Ryzzen/RyzzenKeyboard/layout/output.stl

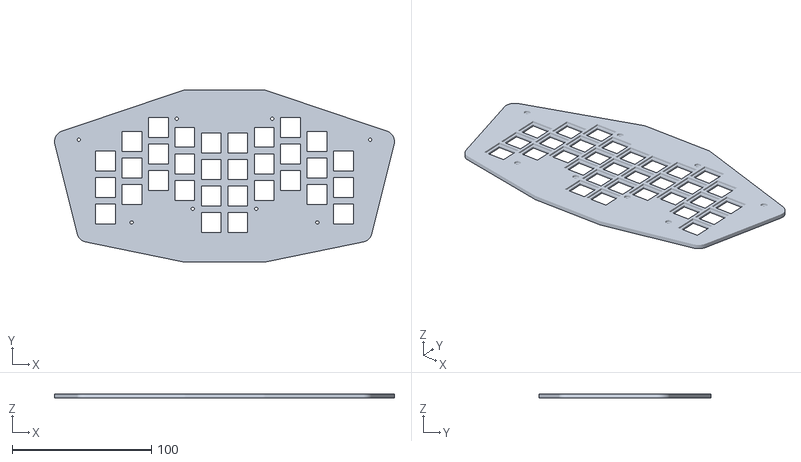
[picture p20: CAD file, 2026-03-23]
layout/output.stl
244.1 x 123.8 x 3.00
