Ryzzen/RyzzenKeyboard/layout/output/outlines/m2_countersink.dxf

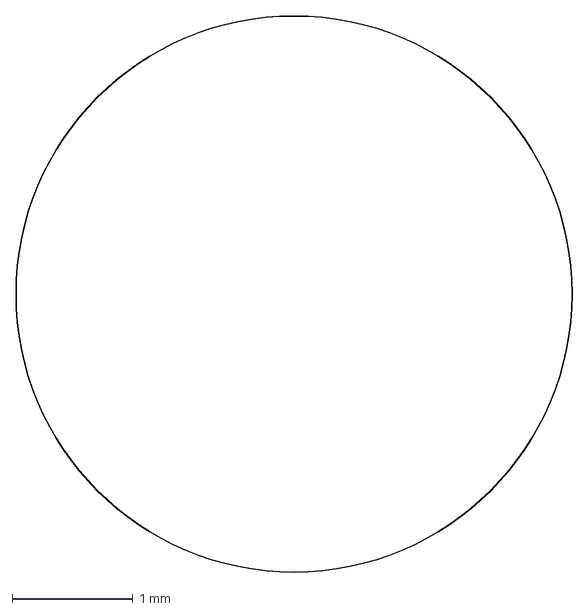
[picture p21: CAD file, 2026-03-23]
layout/output/outlines/m2_countersink.dxf
4.60 x 4.60 mm
