Ryzzen/RyzzenKeyboard/librairies/ECS-250-8-30B-CKM/ECS-250-8-30B-CKM.step

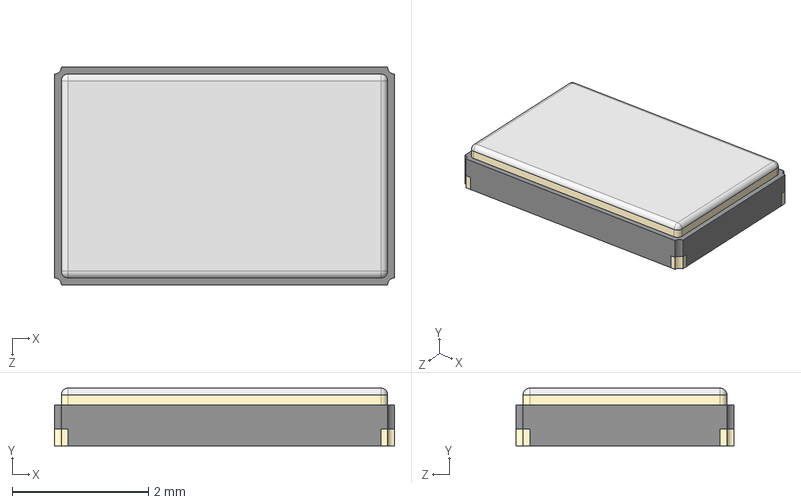
[picture p22: CAD file, 2025-12-25]
librairies/ECS-250-8-30B-CKM/ECS-250-8-30B-CKM.step
5.00 x 0.85 x 3.20 mm
