Ryzzen/RyzzenKeyboard/layout/output/outlines/m2_through.dxf

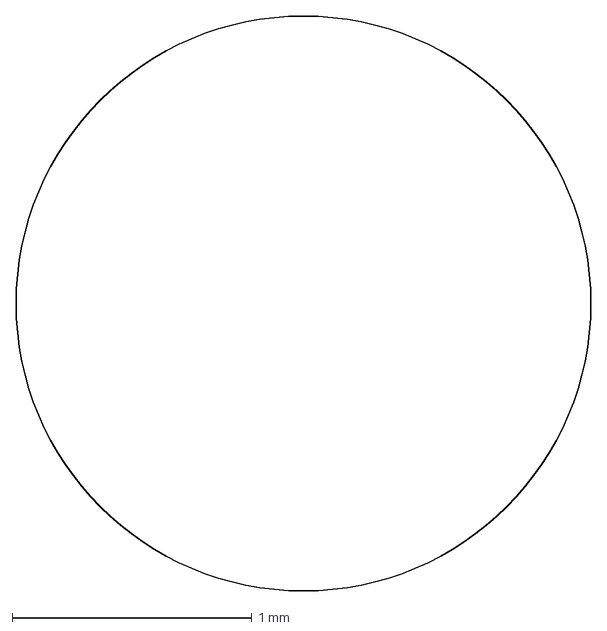
[picture p23: CAD file, 2026-03-23]
layout/output/outlines/m2_through.dxf
2.40 x 2.40 mm
