Ryzzen/RyzzenKeyboard/layout/output/outlines/switch_cutout_retention.dxf

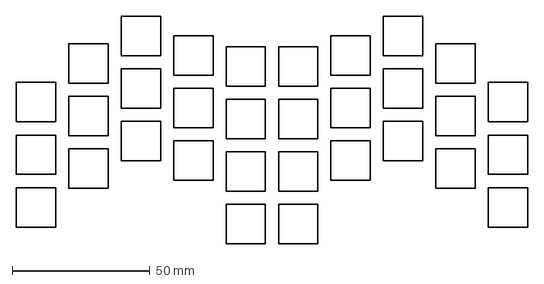
[picture p24: CAD file, 2026-03-23]
layout/output/outlines/switch_cutout_retention.dxf
185.3 x 82.4 mm
