Ryzzen/RyzzenKeyboard/layout/output/outlines/board.dxf

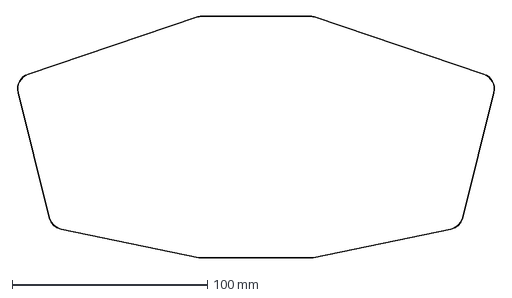
[picture p25: CAD file, 2026-03-23]
layout/output/outlines/board.dxf
245.7 x 123.8 mm
