Ryzzen/RyzzenKeyboard/layout/output/outlines/plate_top.dxf

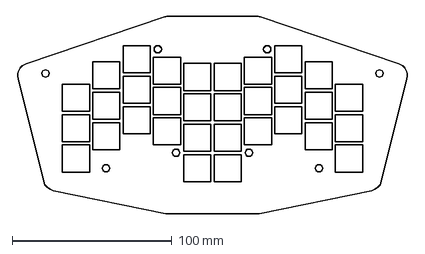
[picture p26: CAD file, 2026-03-23]
layout/output/outlines/plate_top.dxf
245.7 x 123.8 mm
