Ryzzen/RyzzenKeyboard/layout/output/outlines/plate_bottom.dxf

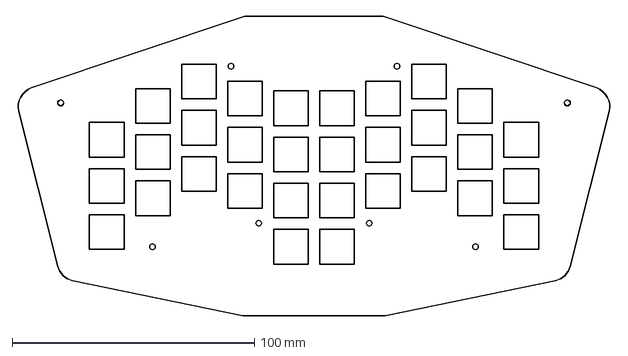
[picture p27: CAD file, 2026-03-23]
layout/output/outlines/plate_bottom.dxf
245.7 x 123.8 mm
