Ryzzen/RyzzenKeyboard/layout/output/outlines/plate_holes.dxf

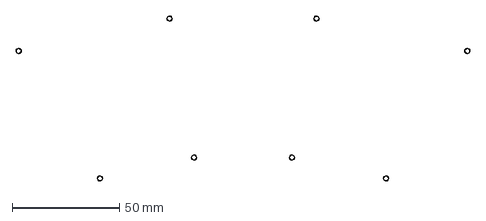
[picture p28: CAD file, 2026-03-23]
layout/output/outlines/plate_holes.dxf
211.6 x 76.9 mm
