Ryzzen/RyzzenKeyboard/layout/output/outlines/plate_countersinks.dxf

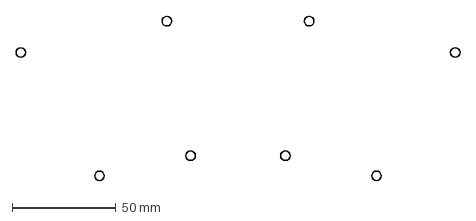
[picture p29: CAD file, 2026-03-23]
layout/output/outlines/plate_countersinks.dxf
213.8 x 79.1 mm
