Ryzzen/RyzzenKeyboard/layout/output/outlines/switch_cutout_clearance.dxf

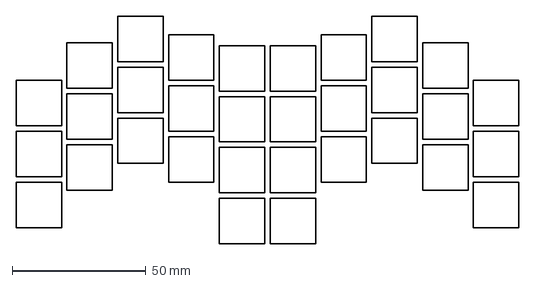
[picture p30: CAD file, 2026-03-23]
layout/output/outlines/switch_cutout_clearance.dxf
188.1 x 85.2 mm
