Ryzzen/RyzzenKeyboard/(list of files, cad)

Other CAD files:
layout/plate.FCStd
