Ryzzen/RyzzenKeyboard/RyzzenKeyboard.kicad_pcb

## KiCad design RyzzenKeyboard.kicad_pcb (2026-04-11)

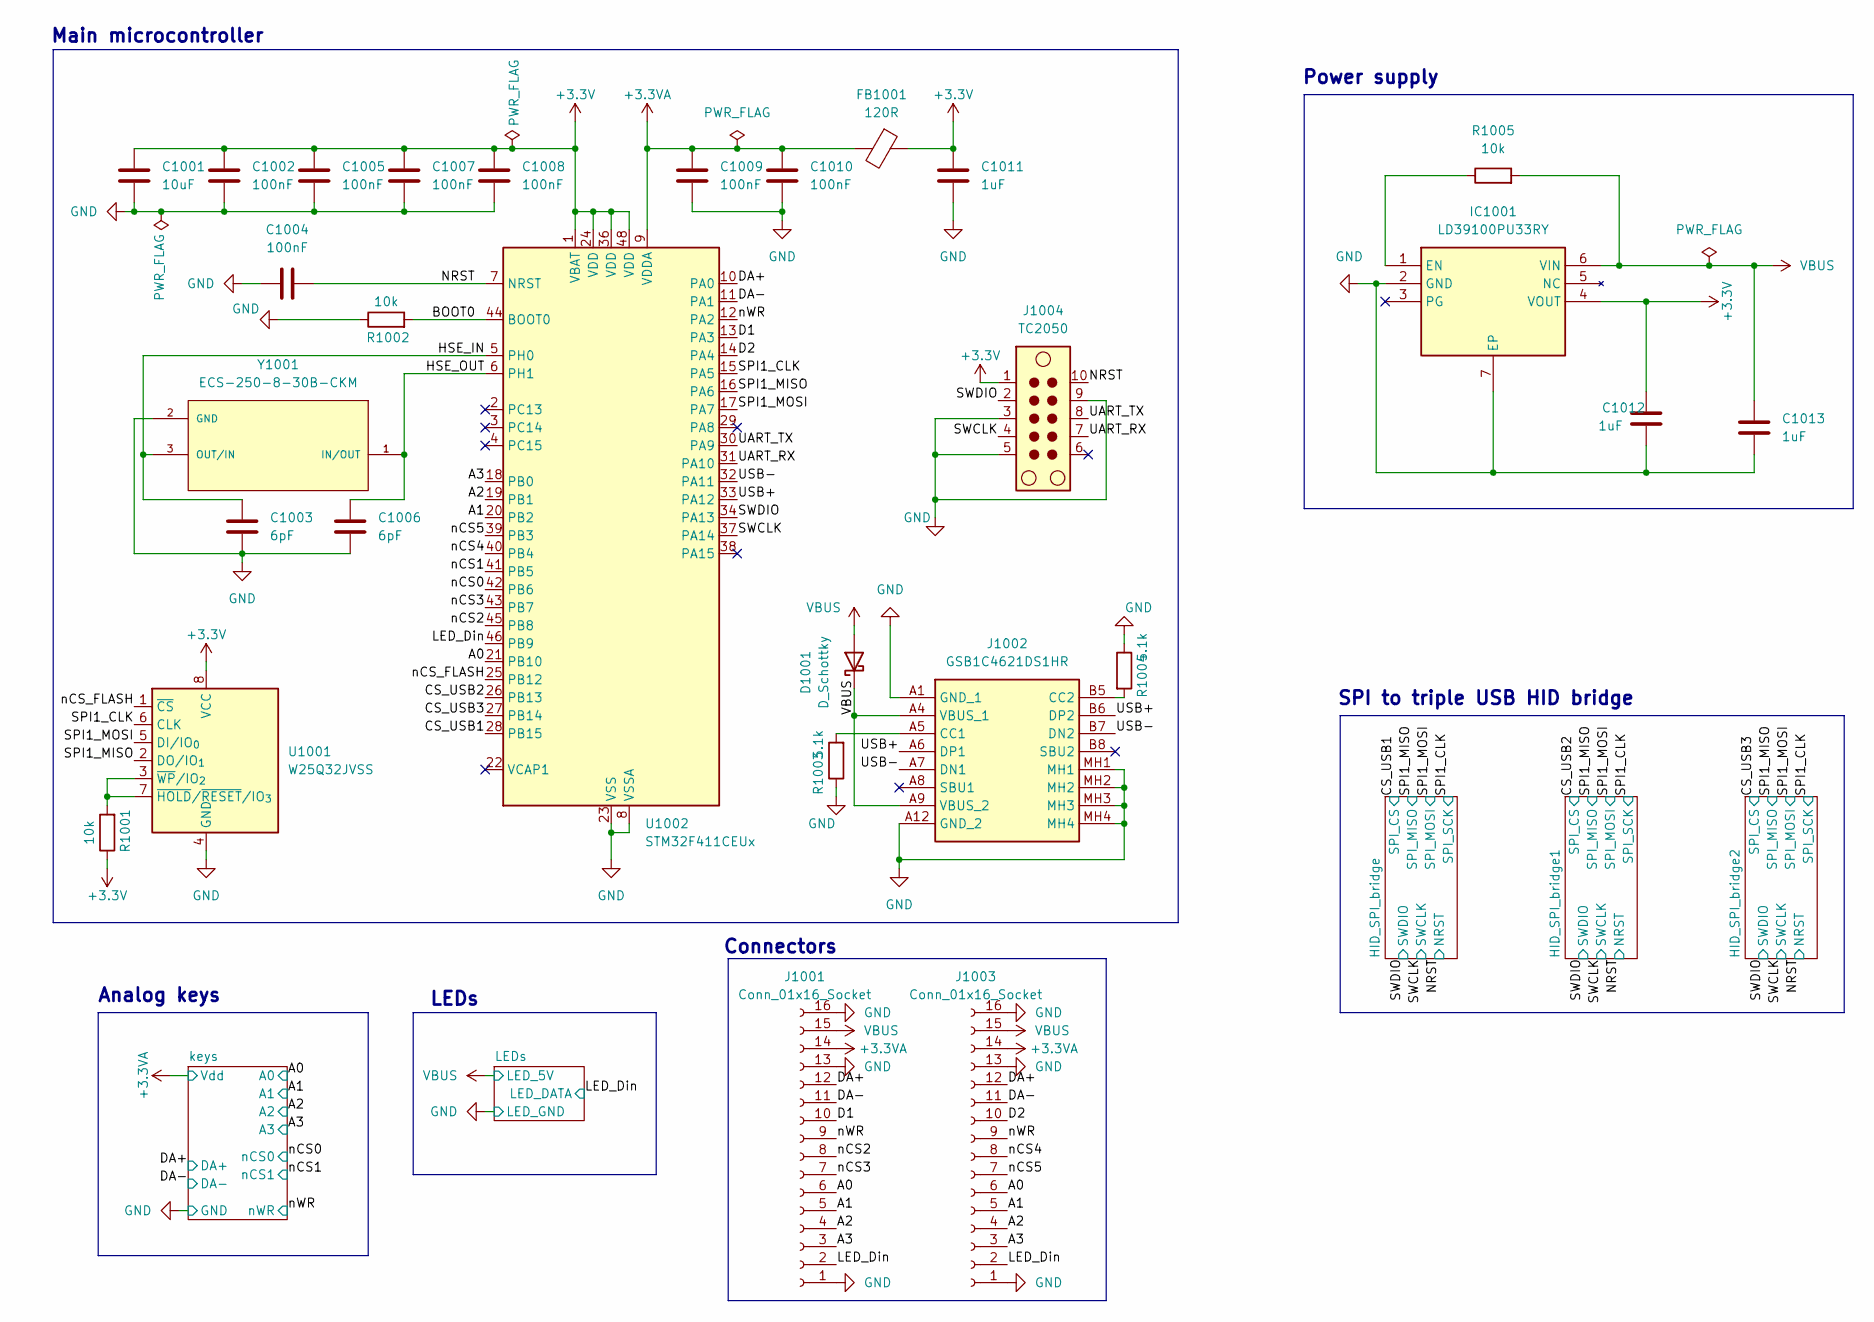
[picture p31: schematic RyzzenKeyboard.kicad_sch, TMR based triple USB Keyboard]

Parts:
C1001: 10uF; C_0603_1608Metric_Pad1.08x0.95mm_HandSolder
C1002, C1004, C1005, C1007, C1008, C1009, C1010: 100nF; C_0603_1608Metric_Pad1.08x0.95mm_HandSolder
C1003, C1006: 6pF; C_0603_1608Metric_Pad1.08x0.95mm_HandSolder
C1011, C1012, C1013: 1uF; C_0603_1608Metric_Pad1.08x0.95mm_HandSolder
D1001: D_Schottky; CUHS20S40H3F
FB1001: 120R; BLM21AG102BH1J
IC1001: LD39100PU33RY; SON95P300X300X90-7N-D; Mouser Part Number 511-LD39100PU33RY
J1001, J1003: Conn_01x16_Socket; JST_XH_S16B-XH-A_1x16_P2.50mm_Horizontal
J1002: GSB1C4621DS1HR; Manufacturer_Part_Number GSB1C4621DS1HR
J1004: TC2050; Tag-Connect_TC2050-IDC-NL_2x05_P1.27mm_Vertical
R1001, R1002, R1005: 10k; R_0603_1608Metric_Pad0.98x0.95mm_HandSolder
R1003, R1004: 5.1k; R_0603_1608Metric_Pad0.98x0.95mm_HandSolder
U1001: W25Q32JVSS; SOIC-8_5.3x5.3mm_P1.27mm
U1002: STM32F411CEUx; QFN-48-1EP_7x7mm_P0.5mm_EP5.6x5.6mm
Y1001: ECS-250-8-30B-CKM; XTAL_ECS-250-8-30B-CKM

Connections:
+3.3V: C1001.1, C1002.1, C1005.1, C1007.1, C1008.1, C1011.1, C1012.1, FB1001.1, IC1001.4 (VOUT), J1004.1, R1001.1, U1001.8 (VCC), U1002.1 (VBAT), U1002.24 (VDD), U1002.36 (VDD), U1002.48 (VDD); also elsewhere on the board
+3.3VA: C1009.1, C1010.1, FB1001.2, J1001.14, J1003.14, U1002.9 (VDDA); also elsewhere on the board
/A0: J1001.6, J1003.6, U1002.21 (PB10); also elsewhere on the board
/A1: J1001.5, J1003.5, U1002.20 (PB2); also elsewhere on the board
/A2: J1001.4, J1003.4, U1002.19 (PB1); also elsewhere on the board
/A3: J1001.3, J1003.3, U1002.18 (PB0); also elsewhere on the board
/BOOT0: R1002.2, U1002.44 (BOOT0)
/CS_USB1: U1002.28 (PB15); also elsewhere on the board
/CS_USB2: U1002.26 (PB13); also elsewhere on the board
/CS_USB3: U1002.27 (PB14); also elsewhere on the board
/D1: J1001.10, U1002.13 (PA3)
/D2: J1003.10, U1002.14 (PA4)
/DA+: J1001.12, J1003.12, U1002.10 (PA0); also elsewhere on the board
/DA-: J1001.11, J1003.11, U1002.11 (PA1); also elsewhere on the board
/HSE_IN: C1003.1, U1002.5 (PH0), Y1001.3 (OUT/IN)
/HSE_OUT: C1006.1, U1002.6 (PH1), Y1001.1 (IN/OUT)
/LED_Din: J1001.2, J1003.2, U1002.46 (PB9); also elsewhere on the board
/NRST: C1004.1, J1004.10, U1002.7 (NRST); also elsewhere on the board
/SPI1_CLK: U1001.6 (CLK), U1002.15 (PA5); also elsewhere on the board
/SPI1_MISO: U1001.2 (DO/IO_{1}), U1002.16 (PA6); also elsewhere on the board
/SPI1_MOSI: U1001.5 (DI/IO_{0}), U1002.17 (PA7); also elsewhere on the board
/SWCLK: J1004.4, U1002.37 (PA14); also elsewhere on the board
/SWDIO: J1004.2, U1002.34 (PA13); also elsewhere on the board
/UART_RX: J1004.7, U1002.31 (PA10)
/UART_TX: J1004.8, U1002.30 (PA9)
/USB+: J1002.A6 (DP1), J1002.B6 (DP2), U1002.33 (PA12)
/USB-: J1002.A7 (DN1), J1002.B7 (DN2), U1002.32 (PA11)
/nCS0: U1002.42 (PB6); also elsewhere on the board
/nCS1: U1002.41 (PB5); also elsewhere on the board
/nCS2: J1001.8, U1002.45 (PB8)
/nCS3: J1001.7, U1002.43 (PB7)
/nCS4: J1003.8, U1002.40 (PB4)
/nCS5: J1003.7, U1002.39 (PB3)
/nCS_FLASH: U1001.1 (~CS), U1002.25 (PB12)
/nWR: J1001.9, J1003.9, U1002.12 (PA2); also elsewhere on the board
GND: C1001.2, C1002.2, C1003.2, C1004.2, C1005.2, C1006.2, C1007.2, C1008.2, C1009.2, C1010.2, C1011.2, C1012.2, C1013.2, IC1001.2 (GND), IC1001.7 (EP), J1001.1, J1001.13, J1001.16, J1002.A1 (GND_1), J1002.A12 (GND_2), J1002.MH1, J1002.MH2, J1002.MH3, J1002.MH4, J1003.1, J1003.13, J1003.16, J1004.3, J1004.5, J1004.9, R1002.1, R1003.1, R1004.1, U1001.4 (GND), U1002.8 (VSSA), U1002.23 (VSS), U1002.35 (VSS), U1002.47 (VSS), U1002.49 (VSS), Y1001.2 (GND), Y1001.4 (GND); also elsewhere on the board
unnamed: IC1001.1 (EN), R1005.1
unnamed: J1002.A5 (CC1), R1003.2
unnamed: J1002.B5 (CC2), R1004.2
unnamed: R1001.2, U1001.3 (~WP/IO_{2}), U1001.7 (~HOLD/~RESET/IO_{3})
VBUS: C1013.1, D1001.1 (K), D1001.2 (A), IC1001.6 (VIN), J1001.15, J1002.A4 (VBUS_1), J1002.A9 (VBUS_2), J1003.15, R1005.2; also elsewhere on the board

Notes on the sheet:
Main microcontroller
Power supply
LEDs
Connectors
Analog keys
SPI to triple USB HID bridge

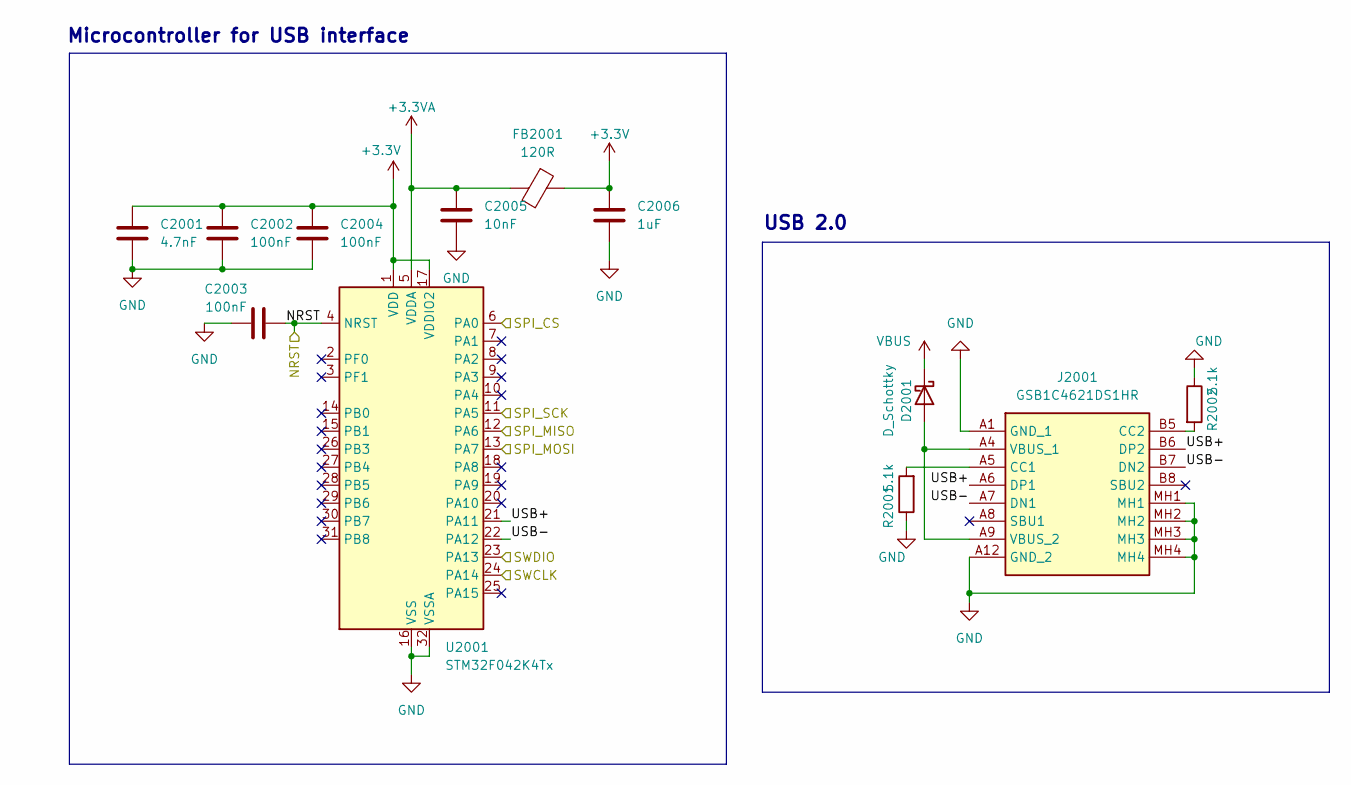
[picture p32: schematic HID_SPI_bridge.kicad_sch, TMR based triple USB Keyboard]

Parts:
C2001: 4.7nF; C_0603_1608Metric_Pad1.08x0.95mm_HandSolder
C2002, C2003, C2004: 100nF; C_0603_1608Metric_Pad1.08x0.95mm_HandSolder
C2005: 10nF; C_0603_1608Metric_Pad1.08x0.95mm_HandSolder
C2006: 1uF; C_0603_1608Metric_Pad1.08x0.95mm_HandSolder
D2001: D_Schottky; CUHS20S40H3F
FB2001: 120R; BLM21AG102BH1J
J2001: GSB1C4621DS1HR; Manufacturer_Part_Number GSB1C4621DS1HR
R2001, R2002: 5.1k; R_0603_1608Metric_Pad0.98x0.95mm_HandSolder
U2001: STM32F042K4Tx; LQFP-32_7x7mm_P0.8mm

Connections:
+3.3V: C2001.1, C2002.1, C2004.1, C2006.1, FB2001.1, U2001.1 (VDD), U2001.17 (VDDIO2); also elsewhere on the board
+3.3VA: C2005.1, FB2001.2, U2001.5 (VDDA); also elsewhere on the board
/CS_USB1: U2001.6 (PA0); also elsewhere on the board
/HID_SPI_bridge/USB+: J2001.A6 (DP1), J2001.B6 (DP2), U2001.21 (PA11)
/HID_SPI_bridge/USB-: J2001.A7 (DN1), J2001.B7 (DN2), U2001.22 (PA12)
/NRST: C2003.2, U2001.4 (NRST); also elsewhere on the board
/SPI1_CLK: U2001.11 (PA5); also elsewhere on the board
/SPI1_MISO: U2001.12 (PA6); also elsewhere on the board
/SPI1_MOSI: U2001.13 (PA7); also elsewhere on the board
/SWCLK: U2001.24 (PA14); also elsewhere on the board
/SWDIO: U2001.23 (PA13); also elsewhere on the board
GND: C2001.2, C2002.2, C2003.1, C2004.2, C2005.2, C2006.2, J2001.A1 (GND_1), J2001.A12 (GND_2), J2001.MH1, J2001.MH2, J2001.MH3, J2001.MH4, R2001.1, R2002.1, U2001.16 (VSS), U2001.32 (VSSA); also elsewhere on the board
unnamed: D2001.2 (A), J2001.A4 (VBUS_1), J2001.A9 (VBUS_2)
unnamed: J2001.A5 (CC1), R2001.2
unnamed: J2001.B5 (CC2), R2002.2
VBUS: D2001.1 (K); also elsewhere on the board

Parts of its further copies:
C207001, C208001: 4.7nF; C_0603_1608Metric_Pad1.08x0.95mm_HandSolder
C207002, C207003, C207004, C208002, C208003, C208004: 100nF; C_0603_1608Metric_Pad1.08x0.95mm_HandSolder
C207005, C208005: 10nF; C_0603_1608Metric_Pad1.08x0.95mm_HandSolder
C207006, C208006: 1uF; C_0603_1608Metric_Pad1.08x0.95mm_HandSolder
D207001, D208001: D_Schottky; CUHS20S40H3F
FB207001, FB208001: 120R; BLM21AG102BH1J
J207001, J208001: GSB1C4621DS1HR; Manufacturer_Part_Number GSB1C4621DS1HR
R207001, R207002, R208001, R208002: 5.1k; R_0603_1608Metric_Pad0.98x0.95mm_HandSolder
U207001, U208001: STM32F042K4Tx; LQFP-32_7x7mm_P0.8mm

Connections of its further copies:
+3.3V: C207001.1, C207002.1, C207004.1, C207006.1, C208001.1, C208002.1, C208004.1, C208006.1, FB207001.1, FB208001.1, U207001.1 (VDD), U207001.17 (VDDIO2), U208001.1 (VDD), U208001.17 (VDDIO2); also elsewhere on the board
+3.3VA: C207005.1, C208005.1, FB207001.2, FB208001.2, U207001.5 (VDDA), U208001.5 (VDDA); also elsewhere on the board
/CS_USB2: U208001.6 (PA0); also elsewhere on the board
/CS_USB3: U207001.6 (PA0); also elsewhere on the board
/HID_SPI_bridge1/USB+: J208001.A6 (DP1), J208001.B6 (DP2), U208001.21 (PA11)
/HID_SPI_bridge1/USB-: J208001.A7 (DN1), J208001.B7 (DN2), U208001.22 (PA12)
/HID_SPI_bridge2/USB+: J207001.A6 (DP1), J207001.B6 (DP2), U207001.21 (PA11)
/HID_SPI_bridge2/USB-: J207001.A7 (DN1), J207001.B7 (DN2), U207001.22 (PA12)
/NRST: C207003.2, C208003.2, U207001.4 (NRST), U208001.4 (NRST); also elsewhere on the board
/SPI1_CLK: U207001.11 (PA5), U208001.11 (PA5); also elsewhere on the board
/SPI1_MISO: U207001.12 (PA6), U208001.12 (PA6); also elsewhere on the board
/SPI1_MOSI: U207001.13 (PA7), U208001.13 (PA7); also elsewhere on the board
/SWCLK: U207001.24 (PA14), U208001.24 (PA14); also elsewhere on the board
/SWDIO: U207001.23 (PA13), U208001.23 (PA13); also elsewhere on the board
GND: C207001.2, C207002.2, C207003.1, C207004.2, C207005.2, C207006.2, C208001.2, C208002.2, C208003.1, C208004.2, C208005.2, C208006.2, J207001.A1 (GND_1), J207001.A12 (GND_2), J207001.MH1, J207001.MH2, J207001.MH3, J207001.MH4, J208001.A1 (GND_1), J208001.A12 (GND_2), J208001.MH1, J208001.MH2, J208001.MH3, J208001.MH4, R207001.1, R207002.1, R208001.1, R208002.1, U207001.16 (VSS), U207001.32 (VSSA), U208001.16 (VSS), U208001.32 (VSSA); also elsewhere on the board
unnamed: D207001.2 (A), J207001.A4 (VBUS_1), J207001.A9 (VBUS_2)
unnamed: D208001.2 (A), J208001.A4 (VBUS_1), J208001.A9 (VBUS_2)
unnamed: J207001.A5 (CC1), R207001.2
unnamed: J207001.B5 (CC2), R207002.2
unnamed: J208001.A5 (CC1), R208001.2
unnamed: J208001.B5 (CC2), R208002.2
VBUS: D207001.1 (K), D208001.1 (K); also elsewhere on the board

Notes on the sheet:
Microcontroller for USB interface
USB 2.0

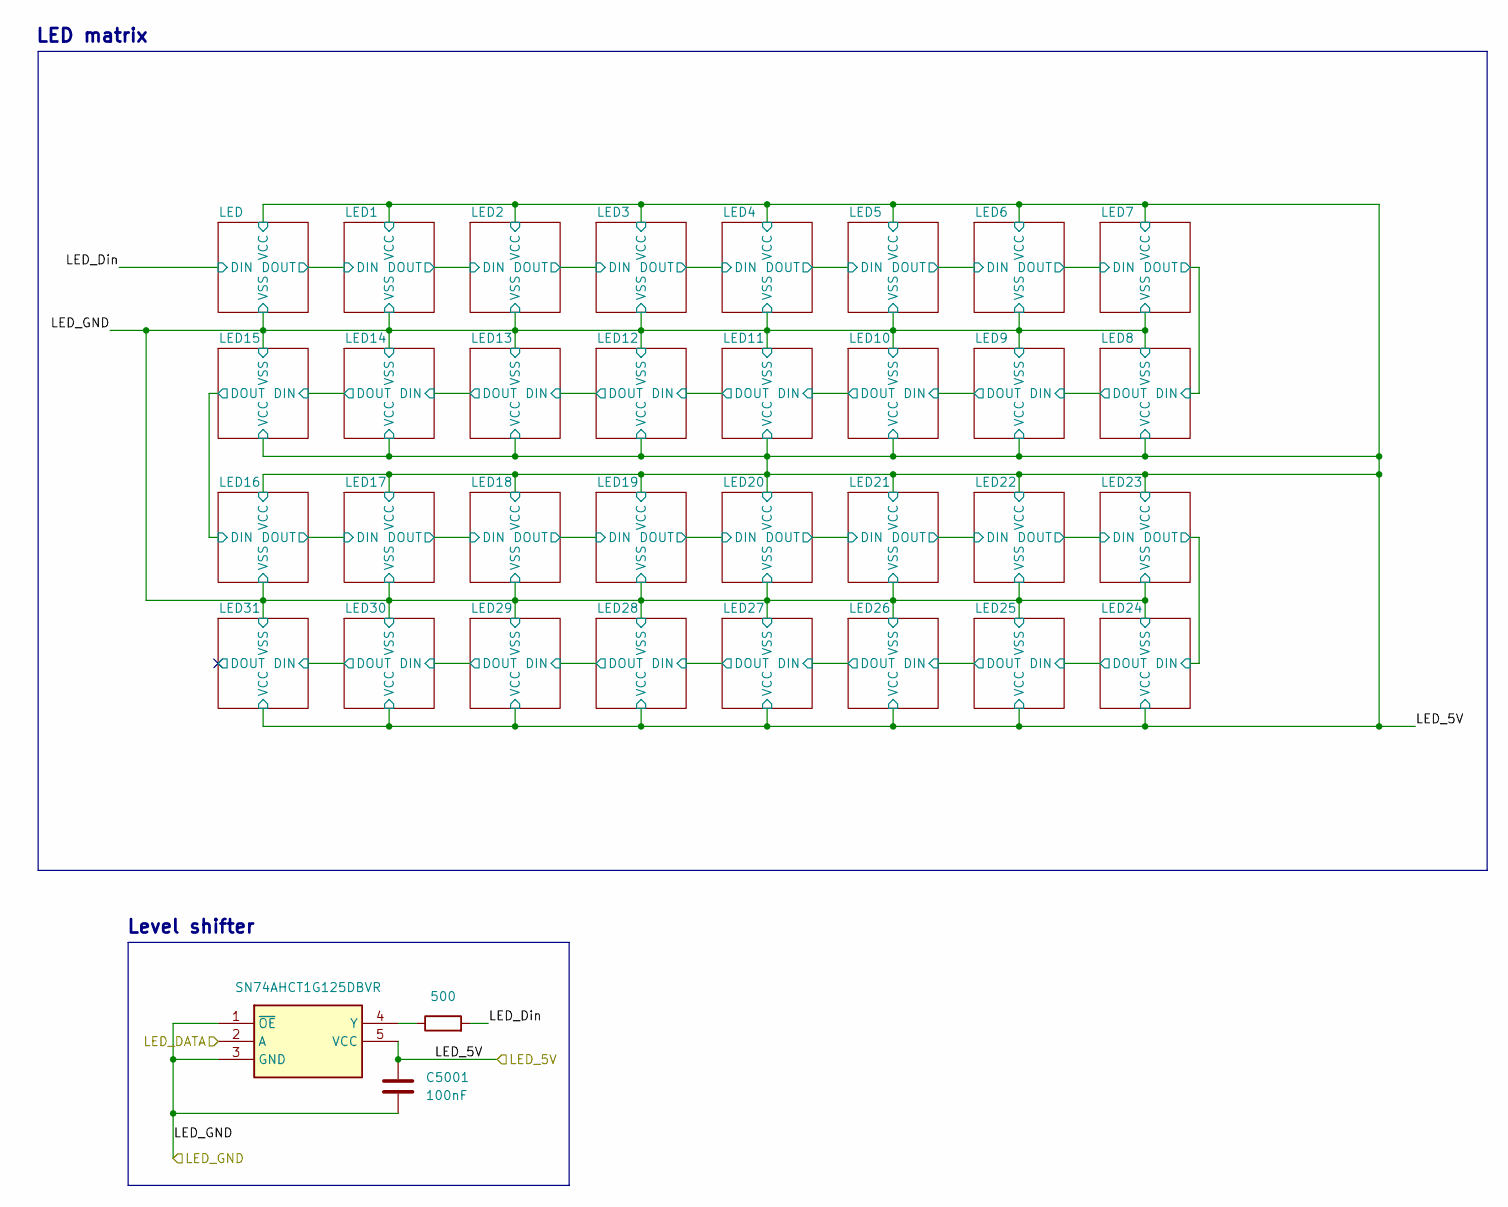
[picture p33: schematic leds.kicad_sch, TMR based triple USB Keyboard]

Parts:
C5001: 100nF; C_0603_1608Metric_Pad1.08x0.95mm_HandSolder
IC5001: SN74AHCT1G125DBVR; SOT95P280X145-5N; Mouser Part Number 595-SNAHCT1G125DBVR
R5001: 500; R_0603_1608Metric_Pad0.98x0.95mm_HandSolder

Connections:
/LED_Din: IC5001.2 (A); also elsewhere on the board
/LEDs/LED_Din: R5001.2; also elsewhere on the board
GND: C5001.1, IC5001.1 (~OE), IC5001.3 (GND); also elsewhere on the board
unnamed: IC5001.4 (Y), R5001.1
VBUS: C5001.2, IC5001.5 (VCC); also elsewhere on the board

Notes on the sheet:
LED matrix
Level shifter

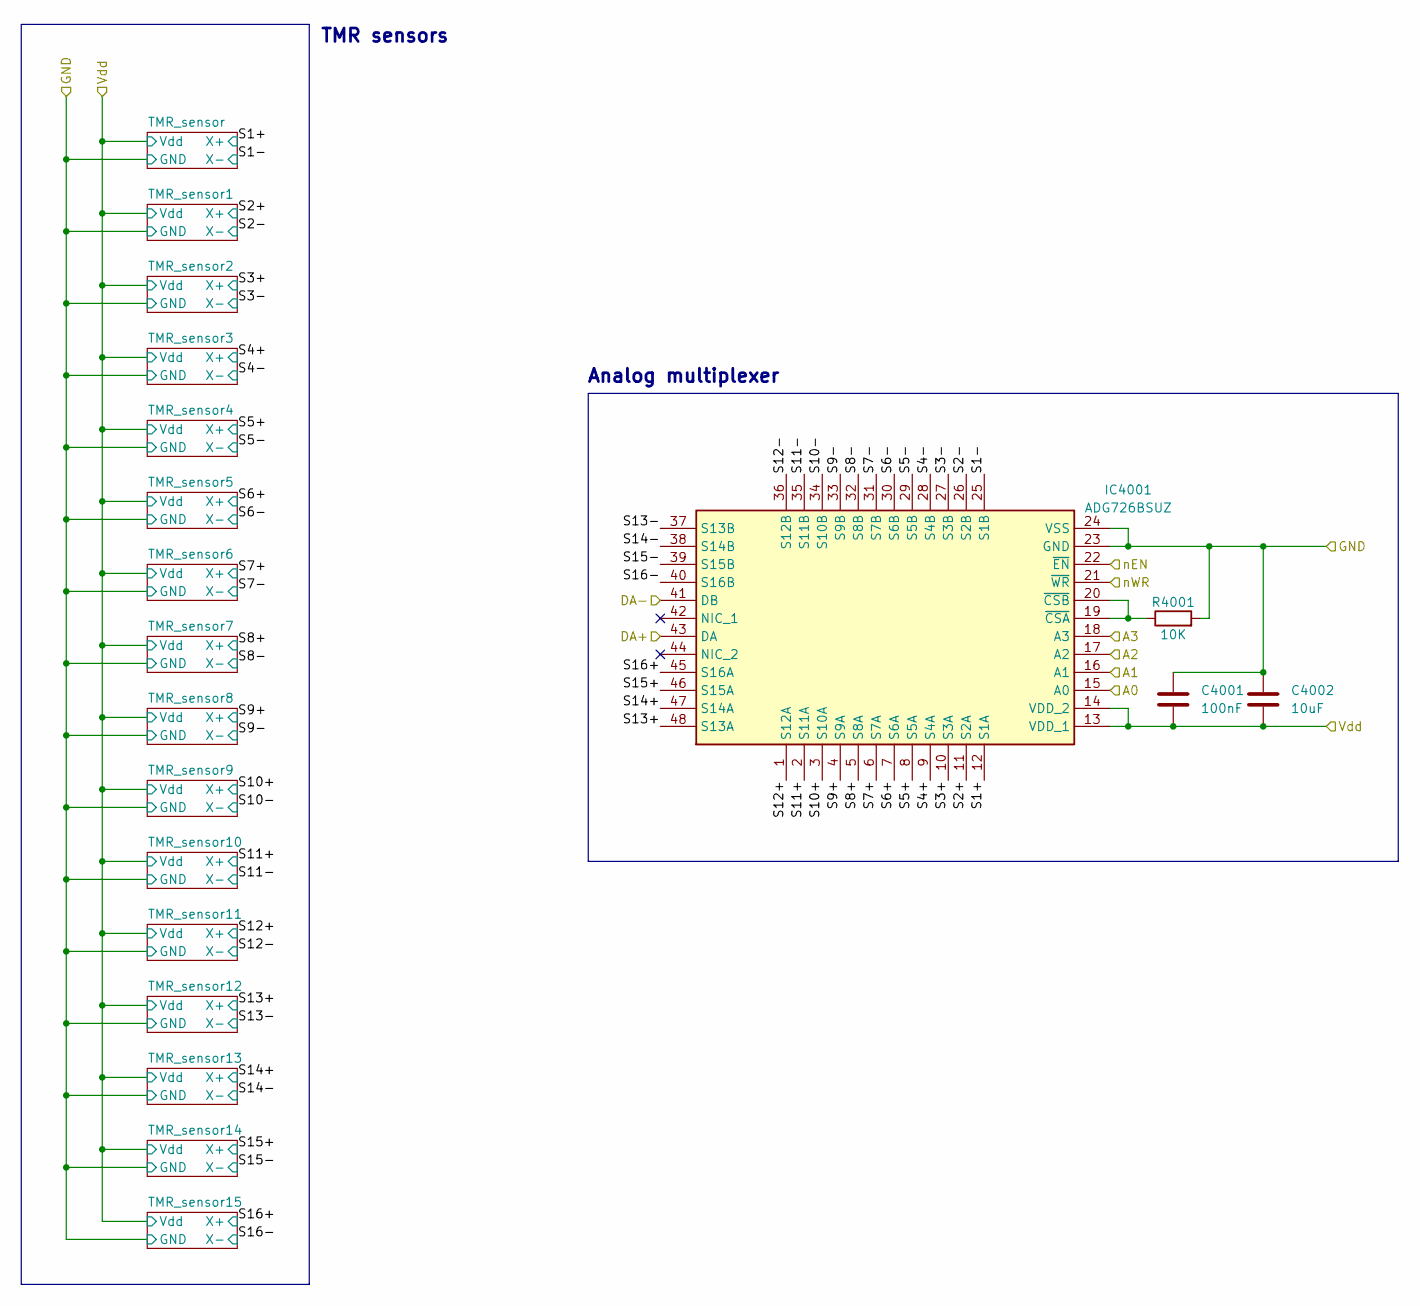
[picture p34: schematic key_bank.kicad_sch, TMR based triple USB Keyboard]

Parts:
C4001: 100nF; C_0603_1608Metric_Pad1.08x0.95mm_HandSolder
C4002: 10uF; C_0603_1608Metric_Pad1.08x0.95mm_HandSolder
IC4001: ADG726BSUZ; QFP50P900X900X120-48N; Mouser Part Number 584-ADG726BSUZ
R4001: 10K; R_0603_1608Metric_Pad0.98x0.95mm_HandSolder

Connections:
+3.3VA: C4001.2, C4002.2, IC4001.13 (VDD_1), IC4001.14 (VDD_2); also elsewhere on the board
/A0: IC4001.15 (A0); also elsewhere on the board
/A1: IC4001.16 (A1); also elsewhere on the board
/A2: IC4001.17 (A2); also elsewhere on the board
/A3: IC4001.18 (A3); also elsewhere on the board
/DA+: IC4001.43 (DA); also elsewhere on the board
/DA-: IC4001.41 (DB); also elsewhere on the board
/keys/key_bank2/S1+: IC4001.12 (S1A); also elsewhere on the board
/keys/key_bank2/S1-: IC4001.25 (S1B); also elsewhere on the board
/keys/key_bank2/S2+: IC4001.11 (S2A); also elsewhere on the board
/keys/key_bank2/S2-: IC4001.26 (S2B); also elsewhere on the board
/keys/key_bank2/S3+: IC4001.10 (S3A); also elsewhere on the board
/keys/key_bank2/S3-: IC4001.27 (S3B); also elsewhere on the board
/keys/key_bank2/S4+: IC4001.9 (S4A); also elsewhere on the board
/keys/key_bank2/S4-: IC4001.28 (S4B); also elsewhere on the board
/keys/key_bank2/S5+: IC4001.8 (S5A); also elsewhere on the board
/keys/key_bank2/S5-: IC4001.29 (S5B); also elsewhere on the board
/keys/key_bank2/S6+: IC4001.7 (S6A); also elsewhere on the board
/keys/key_bank2/S6-: IC4001.30 (S6B); also elsewhere on the board
/keys/key_bank2/S7+: IC4001.6 (S7A); also elsewhere on the board
/keys/key_bank2/S7-: IC4001.31 (S7B); also elsewhere on the board
/keys/key_bank2/S8+: IC4001.5 (S8A); also elsewhere on the board
/keys/key_bank2/S8-: IC4001.32 (S8B); also elsewhere on the board
/keys/key_bank2/S9+: IC4001.4 (S9A); also elsewhere on the board
/keys/key_bank2/S9-: IC4001.33 (S9B); also elsewhere on the board
/keys/key_bank2/S10+: IC4001.3 (S10A); also elsewhere on the board
/keys/key_bank2/S10-: IC4001.34 (S10B); also elsewhere on the board
/keys/key_bank2/S11+: IC4001.2 (S11A); also elsewhere on the board
/keys/key_bank2/S11-: IC4001.35 (S11B); also elsewhere on the board
/keys/key_bank2/S12+: IC4001.1 (S12A); also elsewhere on the board
/keys/key_bank2/S12-: IC4001.36 (S12B); also elsewhere on the board
/keys/key_bank2/S13+: IC4001.48 (S13A); also elsewhere on the board
/keys/key_bank2/S13-: IC4001.37 (S13B); also elsewhere on the board
/keys/key_bank2/S14+: IC4001.47 (S14A); also elsewhere on the board
/keys/key_bank2/S14-: IC4001.38 (S14B); also elsewhere on the board
/keys/key_bank2/S15+: IC4001.46 (S15A); also elsewhere on the board
/keys/key_bank2/S15-: IC4001.39 (S15B); also elsewhere on the board
/keys/key_bank2/S16+: IC4001.45 (S16A); also elsewhere on the board
/keys/key_bank2/S16-: IC4001.40 (S16B); also elsewhere on the board
/nCS0: IC4001.22 (~EN); also elsewhere on the board
/nWR: IC4001.21 (~WR); also elsewhere on the board
GND: C4001.1, C4002.1, IC4001.23 (GND), IC4001.24 (VSS), R4001.2; also elsewhere on the board
unnamed: IC4001.19 (~CSA), IC4001.20 (~CSB), R4001.1

Parts of its further copies:
C204001: 100nF; C_0603_1608Metric_Pad1.08x0.95mm_HandSolder
C204002: 10uF; C_0603_1608Metric_Pad1.08x0.95mm_HandSolder
IC204001: ADG726BSUZ; QFP50P900X900X120-48N; Mouser Part Number 584-ADG726BSUZ
R204001: 10K; R_0603_1608Metric_Pad0.98x0.95mm_HandSolder

Connections of its further copies:
+3.3VA: C204001.2, C204002.2, IC204001.13 (VDD_1), IC204001.14 (VDD_2); also elsewhere on the board
/A0: IC204001.15 (A0); also elsewhere on the board
/A1: IC204001.16 (A1); also elsewhere on the board
/A2: IC204001.17 (A2); also elsewhere on the board
/A3: IC204001.18 (A3); also elsewhere on the board
/DA+: IC204001.43 (DA); also elsewhere on the board
/DA-: IC204001.41 (DB); also elsewhere on the board
/keys/key_bank3/S1+: IC204001.12 (S1A); also elsewhere on the board
/keys/key_bank3/S1-: IC204001.25 (S1B); also elsewhere on the board
/keys/key_bank3/S2+: IC204001.11 (S2A); also elsewhere on the board
/keys/key_bank3/S2-: IC204001.26 (S2B); also elsewhere on the board
/keys/key_bank3/S3+: IC204001.10 (S3A); also elsewhere on the board
/keys/key_bank3/S3-: IC204001.27 (S3B); also elsewhere on the board
/keys/key_bank3/S4+: IC204001.9 (S4A); also elsewhere on the board
/keys/key_bank3/S4-: IC204001.28 (S4B); also elsewhere on the board
/keys/key_bank3/S5+: IC204001.8 (S5A); also elsewhere on the board
/keys/key_bank3/S5-: IC204001.29 (S5B); also elsewhere on the board
/keys/key_bank3/S6+: IC204001.7 (S6A); also elsewhere on the board
/keys/key_bank3/S6-: IC204001.30 (S6B); also elsewhere on the board
/keys/key_bank3/S7+: IC204001.6 (S7A); also elsewhere on the board
/keys/key_bank3/S7-: IC204001.31 (S7B); also elsewhere on the board
/keys/key_bank3/S8+: IC204001.5 (S8A); also elsewhere on the board
/keys/key_bank3/S8-: IC204001.32 (S8B); also elsewhere on the board
/keys/key_bank3/S9+: IC204001.4 (S9A); also elsewhere on the board
/keys/key_bank3/S9-: IC204001.33 (S9B); also elsewhere on the board
/keys/key_bank3/S10+: IC204001.3 (S10A); also elsewhere on the board
/keys/key_bank3/S10-: IC204001.34 (S10B); also elsewhere on the board
/keys/key_bank3/S11+: IC204001.2 (S11A); also elsewhere on the board
/keys/key_bank3/S11-: IC204001.35 (S11B); also elsewhere on the board
/keys/key_bank3/S12+: IC204001.1 (S12A); also elsewhere on the board
/keys/key_bank3/S12-: IC204001.36 (S12B); also elsewhere on the board
/keys/key_bank3/S13+: IC204001.48 (S13A); also elsewhere on the board
/keys/key_bank3/S13-: IC204001.37 (S13B); also elsewhere on the board
/keys/key_bank3/S14+: IC204001.47 (S14A); also elsewhere on the board
/keys/key_bank3/S14-: IC204001.38 (S14B); also elsewhere on the board
/keys/key_bank3/S15+: IC204001.46 (S15A); also elsewhere on the board
/keys/key_bank3/S15-: IC204001.39 (S15B); also elsewhere on the board
/keys/key_bank3/S16+: IC204001.45 (S16A); also elsewhere on the board
/keys/key_bank3/S16-: IC204001.40 (S16B); also elsewhere on the board
/nCS1: IC204001.22 (~EN); also elsewhere on the board
/nWR: IC204001.21 (~WR); also elsewhere on the board
GND: C204001.1, C204002.1, IC204001.23 (GND), IC204001.24 (VSS), R204001.2; also elsewhere on the board
unnamed: IC204001.19 (~CSA), IC204001.20 (~CSB), R204001.1

Notes on the sheet:
TMR sensors
Analog multiplexer

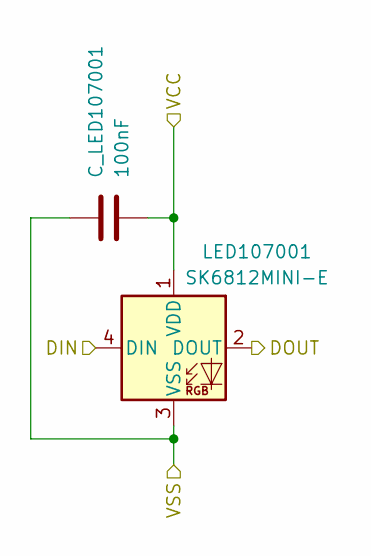
[picture p35: schematic led.kicad_sch, TMR based triple USB Keyboard]

Parts:
C_LED107001: 100nF; C_0603_1608Metric_Pad1.08x0.95mm_HandSolder
LED107001: SK6812MINI-E; MX_SK6812MINI-E_REV

Connections:
/LEDs/LED/DOUT: LED107001.2 (DOUT); also elsewhere on the board
/LEDs/LED_Din: LED107001.4 (DIN); also elsewhere on the board
GND: C_LED107001.2, LED107001.3 (VSS); also elsewhere on the board
VBUS: C_LED107001.1, LED107001.1 (VDD); also elsewhere on the board

Parts of its further copies:
C_LED108001, C_LED109001, C_LED110001, C_LED111001, C_LED112001, C_LED113001, C_LED114001, C_LED115001, C_LED116001, C_LED117001, C_LED118001, C_LED119001, C_LED120001, C_LED121001, C_LED122001, C_LED123001, C_LED124001, C_LED125001, C_LED126001, C_LED127001, C_LED128001, C_LED129001, C_LED130001, C_LED131001, C_LED132001, C_LED133001, C_LED134001, C_LED135001, C_LED136001, C_LED137001, C_LED138001: 100nF; C_0603_1608Metric_Pad1.08x0.95mm_HandSolder
LED108001, LED109001, LED110001, LED111001, LED112001, LED113001, LED114001, LED115001, LED116001, LED117001, LED118001, LED119001, LED120001, LED121001, LED122001, LED123001, LED124001, LED125001, LED126001, LED127001, LED128001, LED129001, LED130001, LED131001, LED132001, LED133001, LED134001, LED135001, LED136001, LED137001, LED138001: SK6812MINI-E; MX_SK6812MINI-E_REV

Connections of its further copies:
/LEDs/LED1/DOUT: LED108001.2 (DOUT), LED109001.4 (DIN)
/LEDs/LED2/DOUT: LED109001.2 (DOUT), LED110001.4 (DIN)
/LEDs/LED3/DOUT: LED110001.2 (DOUT), LED111001.4 (DIN)
/LEDs/LED4/DOUT: LED111001.2 (DOUT), LED112001.4 (DIN)
/LEDs/LED5/DOUT: LED112001.2 (DOUT), LED113001.4 (DIN)
/LEDs/LED6/DOUT: LED113001.2 (DOUT), LED114001.4 (DIN)
/LEDs/LED7/DOUT: LED114001.2 (DOUT), LED115001.4 (DIN)
/LEDs/LED8/DOUT: LED115001.2 (DOUT), LED116001.4 (DIN)
/LEDs/LED10/DIN: LED116001.2 (DOUT), LED117001.4 (DIN)
/LEDs/LED10/DOUT: LED117001.2 (DOUT), LED118001.4 (DIN)
/LEDs/LED11/DOUT: LED118001.2 (DOUT), LED119001.4 (DIN)
/LEDs/LED12/DOUT: LED119001.2 (DOUT), LED120001.4 (DIN)
/LEDs/LED13/DOUT: LED120001.2 (DOUT), LED121001.4 (DIN)
/LEDs/LED14/DOUT: LED121001.2 (DOUT), LED122001.4 (DIN)
/LEDs/LED15/DOUT: LED122001.2 (DOUT), LED123001.4 (DIN)
/LEDs/LED16/DOUT: LED123001.2 (DOUT), LED124001.4 (DIN)
/LEDs/LED17/DOUT: LED124001.2 (DOUT), LED125001.4 (DIN)
/LEDs/LED18/DOUT: LED125001.2 (DOUT), LED126001.4 (DIN)
/LEDs/LED19/DOUT: LED126001.2 (DOUT), LED127001.4 (DIN)
/LEDs/LED20/DOUT: LED127001.2 (DOUT), LED128001.4 (DIN)
/LEDs/LED21/DOUT: LED128001.2 (DOUT), LED129001.4 (DIN)
/LEDs/LED22/DOUT: LED129001.2 (DOUT), LED130001.4 (DIN)
/LEDs/LED23/DOUT: LED130001.2 (DOUT), LED131001.4 (DIN)
/LEDs/LED24/DOUT: LED131001.2 (DOUT), LED132001.4 (DIN)
/LEDs/LED25/DOUT: LED132001.2 (DOUT), LED133001.4 (DIN)
/LEDs/LED26/DOUT: LED133001.2 (DOUT), LED134001.4 (DIN)
/LEDs/LED27/DOUT: LED134001.2 (DOUT), LED135001.4 (DIN)
/LEDs/LED28/DOUT: LED135001.2 (DOUT), LED136001.4 (DIN)
/LEDs/LED29/DOUT: LED136001.2 (DOUT), LED137001.4 (DIN)
/LEDs/LED30/DOUT: LED137001.2 (DOUT), LED138001.4 (DIN)
/LEDs/LED31/DOUT: LED138001.2 (DOUT)
/LEDs/LED/DOUT: LED108001.4 (DIN); also elsewhere on the board
GND: C_LED108001.2, C_LED109001.2, C_LED110001.2, C_LED111001.2, C_LED112001.2, C_LED113001.2, C_LED114001.2, C_LED115001.2, C_LED116001.2, C_LED117001.2, C_LED118001.2, C_LED119001.2, C_LED120001.2, C_LED121001.2, C_LED122001.2, C_LED123001.2, C_LED124001.2, C_LED125001.2, C_LED126001.2, C_LED127001.2, C_LED128001.2, C_LED129001.2, C_LED130001.2, C_LED131001.2, C_LED132001.2, C_LED133001.2, C_LED134001.2, C_LED135001.2, C_LED136001.2, C_LED137001.2, C_LED138001.2, LED108001.3 (VSS), LED109001.3 (VSS), LED110001.3 (VSS), LED111001.3 (VSS), LED112001.3 (VSS), LED113001.3 (VSS), LED114001.3 (VSS), LED115001.3 (VSS), LED116001.3 (VSS), LED117001.3 (VSS), LED118001.3 (VSS), LED119001.3 (VSS), LED120001.3 (VSS), LED121001.3 (VSS), LED122001.3 (VSS), LED123001.3 (VSS), LED124001.3 (VSS), LED125001.3 (VSS), LED126001.3 (VSS), LED127001.3 (VSS), LED128001.3 (VSS), LED129001.3 (VSS), LED130001.3 (VSS), LED131001.3 (VSS), LED132001.3 (VSS), LED133001.3 (VSS), LED134001.3 (VSS), LED135001.3 (VSS), LED136001.3 (VSS), LED137001.3 (VSS), LED138001.3 (VSS); also elsewhere on the board
VBUS: C_LED108001.1, C_LED109001.1, C_LED110001.1, C_LED111001.1, C_LED112001.1, C_LED113001.1, C_LED114001.1, C_LED115001.1, C_LED116001.1, C_LED117001.1, C_LED118001.1, C_LED119001.1, C_LED120001.1, C_LED121001.1, C_LED122001.1, C_LED123001.1, C_LED124001.1, C_LED125001.1, C_LED126001.1, C_LED127001.1, C_LED128001.1, C_LED129001.1, C_LED130001.1, C_LED131001.1, C_LED132001.1, C_LED133001.1, C_LED134001.1, C_LED135001.1, C_LED136001.1, C_LED137001.1, C_LED138001.1, LED108001.1 (VDD), LED109001.1 (VDD), LED110001.1 (VDD), LED111001.1 (VDD), LED112001.1 (VDD), LED113001.1 (VDD), LED114001.1 (VDD), LED115001.1 (VDD), LED116001.1 (VDD), LED117001.1 (VDD), LED118001.1 (VDD), LED119001.1 (VDD), LED120001.1 (VDD), LED121001.1 (VDD), LED122001.1 (VDD), LED123001.1 (VDD), LED124001.1 (VDD), LED125001.1 (VDD), LED126001.1 (VDD), LED127001.1 (VDD), LED128001.1 (VDD), LED129001.1 (VDD), LED130001.1 (VDD), LED131001.1 (VDD), LED132001.1 (VDD), LED133001.1 (VDD), LED134001.1 (VDD), LED135001.1 (VDD), LED136001.1 (VDD), LED137001.1 (VDD), LED138001.1 (VDD); also elsewhere on the board
