Ryzzen/RyzzenKeyboard/RyzzenKeyboard.kicad_pcb

## KiCad design RyzzenKeyboard.kicad_pcb (continued)

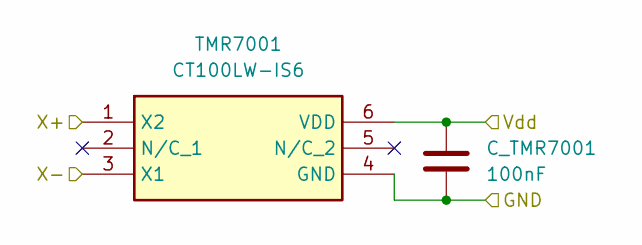
[picture p36: schematic he_sensor.kicad_sch, TMR based triple USB Keyboard]

Parts:
C_TMR7001: 100nF; C_0603_1608Metric_Pad1.08x0.95mm_HandSolder
TMR7001: CT100LW-IS6; SOT95P280X135-6N; Mouser Part Number 462-CT100LW-IS6

Connections:
+3.3VA: C_TMR7001.2, TMR7001.6 (VDD); also elsewhere on the board
/keys/key_bank2/S1+: TMR7001.1 (X2); also elsewhere on the board
/keys/key_bank2/S1-: TMR7001.3 (X1); also elsewhere on the board
GND: C_TMR7001.1, TMR7001.4 (GND); also elsewhere on the board

Parts of its further copies:
C_TMR8001, C_TMR9001, C_TMR10001, C_TMR11001, C_TMR12001, C_TMR13001, C_TMR14001, C_TMR15001, C_TMR16001, C_TMR17001, C_TMR18001, C_TMR19001, C_TMR20001, C_TMR21001, C_TMR22001, C_TMR23001, C_TMR24001, C_TMR25001, C_TMR26001, C_TMR27001, C_TMR28001, C_TMR29001, C_TMR30001, C_TMR31001, C_TMR32001, C_TMR33001, C_TMR34001, C_TMR35001, C_TMR36001, C_TMR37001, C_TMR38001: 100nF; C_0603_1608Metric_Pad1.08x0.95mm_HandSolder
TMR8001, TMR9001, TMR10001, TMR11001, TMR12001, TMR13001, TMR14001, TMR15001, TMR16001, TMR17001, TMR18001, TMR19001, TMR20001, TMR21001, TMR22001, TMR23001, TMR24001, TMR25001, TMR26001, TMR27001, TMR28001, TMR29001, TMR30001, TMR31001, TMR32001, TMR33001, TMR34001, TMR35001, TMR36001, TMR37001, TMR38001: CT100LW-IS6; SOT95P280X135-6N; Mouser Part Number 462-CT100LW-IS6

Connections of its further copies:
+3.3VA: C_TMR8001.2, C_TMR9001.2, C_TMR10001.2, C_TMR11001.2, C_TMR12001.2, C_TMR13001.2, C_TMR14001.2, C_TMR15001.2, C_TMR16001.2, C_TMR17001.2, C_TMR18001.2, C_TMR19001.2, C_TMR20001.2, C_TMR21001.2, C_TMR22001.2, C_TMR23001.2, C_TMR24001.2, C_TMR25001.2, C_TMR26001.2, C_TMR27001.2, C_TMR28001.2, C_TMR29001.2, C_TMR30001.2, C_TMR31001.2, C_TMR32001.2, C_TMR33001.2, C_TMR34001.2, C_TMR35001.2, C_TMR36001.2, C_TMR37001.2, C_TMR38001.2, TMR8001.6 (VDD), TMR9001.6 (VDD), TMR10001.6 (VDD), TMR11001.6 (VDD), TMR12001.6 (VDD), TMR13001.6 (VDD), TMR14001.6 (VDD), TMR15001.6 (VDD), TMR16001.6 (VDD), TMR17001.6 (VDD), TMR18001.6 (VDD), TMR19001.6 (VDD), TMR20001.6 (VDD), TMR21001.6 (VDD), TMR22001.6 (VDD), TMR23001.6 (VDD), TMR24001.6 (VDD), TMR25001.6 (VDD), TMR26001.6 (VDD), TMR27001.6 (VDD), TMR28001.6 (VDD), TMR29001.6 (VDD), TMR30001.6 (VDD), TMR31001.6 (VDD), TMR32001.6 (VDD), TMR33001.6 (VDD), TMR34001.6 (VDD), TMR35001.6 (VDD), TMR36001.6 (VDD), TMR37001.6 (VDD), TMR38001.6 (VDD); also elsewhere on the board
/keys/key_bank2/S2+: TMR8001.1 (X2); also elsewhere on the board
/keys/key_bank2/S2-: TMR8001.3 (X1); also elsewhere on the board
/keys/key_bank2/S3+: TMR9001.1 (X2); also elsewhere on the board
/keys/key_bank2/S3-: TMR9001.3 (X1); also elsewhere on the board
/keys/key_bank2/S4+: TMR10001.1 (X2); also elsewhere on the board
/keys/key_bank2/S4-: TMR10001.3 (X1); also elsewhere on the board
/keys/key_bank2/S5+: TMR11001.1 (X2); also elsewhere on the board
/keys/key_bank2/S5-: TMR11001.3 (X1); also elsewhere on the board
/keys/key_bank2/S6+: TMR12001.1 (X2); also elsewhere on the board
/keys/key_bank2/S6-: TMR12001.3 (X1); also elsewhere on the board
/keys/key_bank2/S7+: TMR13001.1 (X2); also elsewhere on the board
/keys/key_bank2/S7-: TMR13001.3 (X1); also elsewhere on the board
/keys/key_bank2/S8+: TMR14001.1 (X2); also elsewhere on the board
/keys/key_bank2/S8-: TMR14001.3 (X1); also elsewhere on the board
/keys/key_bank2/S9+: TMR15001.1 (X2); also elsewhere on the board
/keys/key_bank2/S9-: TMR15001.3 (X1); also elsewhere on the board
/keys/key_bank2/S10+: TMR16001.1 (X2); also elsewhere on the board
/keys/key_bank2/S10-: TMR16001.3 (X1); also elsewhere on the board
/keys/key_bank2/S11+: TMR17001.1 (X2); also elsewhere on the board
/keys/key_bank2/S11-: TMR17001.3 (X1); also elsewhere on the board
/keys/key_bank2/S12+: TMR18001.1 (X2); also elsewhere on the board
/keys/key_bank2/S12-: TMR18001.3 (X1); also elsewhere on the board
/keys/key_bank2/S13+: TMR19001.1 (X2); also elsewhere on the board
/keys/key_bank2/S13-: TMR19001.3 (X1); also elsewhere on the board
/keys/key_bank2/S14+: TMR20001.1 (X2); also elsewhere on the board
/keys/key_bank2/S14-: TMR20001.3 (X1); also elsewhere on the board
/keys/key_bank2/S15+: TMR21001.1 (X2); also elsewhere on the board
/keys/key_bank2/S15-: TMR21001.3 (X1); also elsewhere on the board
/keys/key_bank2/S16+: TMR38001.1 (X2); also elsewhere on the board
/keys/key_bank2/S16-: TMR38001.3 (X1); also elsewhere on the board
/keys/key_bank3/S1+: TMR23001.1 (X2); also elsewhere on the board
/keys/key_bank3/S1-: TMR23001.3 (X1); also elsewhere on the board
/keys/key_bank3/S2+: TMR24001.1 (X2); also elsewhere on the board
/keys/key_bank3/S2-: TMR24001.3 (X1); also elsewhere on the board
/keys/key_bank3/S3+: TMR25001.1 (X2); also elsewhere on the board
/keys/key_bank3/S3-: TMR25001.3 (X1); also elsewhere on the board
/keys/key_bank3/S4+: TMR26001.1 (X2); also elsewhere on the board
/keys/key_bank3/S4-: TMR26001.3 (X1); also elsewhere on the board
/keys/key_bank3/S5+: TMR27001.1 (X2); also elsewhere on the board
/keys/key_bank3/S5-: TMR27001.3 (X1); also elsewhere on the board
/keys/key_bank3/S6+: TMR28001.1 (X2); also elsewhere on the board
/keys/key_bank3/S6-: TMR28001.3 (X1); also elsewhere on the board
/keys/key_bank3/S7+: TMR29001.1 (X2); also elsewhere on the board
/keys/key_bank3/S7-: TMR29001.3 (X1); also elsewhere on the board
/keys/key_bank3/S8+: TMR30001.1 (X2); also elsewhere on the board
/keys/key_bank3/S8-: TMR30001.3 (X1); also elsewhere on the board
/keys/key_bank3/S9+: TMR31001.1 (X2); also elsewhere on the board
/keys/key_bank3/S9-: TMR31001.3 (X1); also elsewhere on the board
/keys/key_bank3/S10+: TMR32001.1 (X2); also elsewhere on the board
/keys/key_bank3/S10-: TMR32001.3 (X1); also elsewhere on the board
/keys/key_bank3/S11+: TMR33001.1 (X2); also elsewhere on the board
/keys/key_bank3/S11-: TMR33001.3 (X1); also elsewhere on the board
/keys/key_bank3/S12+: TMR34001.1 (X2); also elsewhere on the board
/keys/key_bank3/S12-: TMR34001.3 (X1); also elsewhere on the board
/keys/key_bank3/S13+: TMR35001.1 (X2); also elsewhere on the board
/keys/key_bank3/S13-: TMR35001.3 (X1); also elsewhere on the board
/keys/key_bank3/S14+: TMR36001.1 (X2); also elsewhere on the board
/keys/key_bank3/S14-: TMR36001.3 (X1); also elsewhere on the board
/keys/key_bank3/S15+: TMR37001.1 (X2); also elsewhere on the board
/keys/key_bank3/S15-: TMR37001.3 (X1); also elsewhere on the board
/keys/key_bank3/S16+: TMR22001.1 (X2); also elsewhere on the board
/keys/key_bank3/S16-: TMR22001.3 (X1); also elsewhere on the board
GND: C_TMR8001.1, C_TMR9001.1, C_TMR10001.1, C_TMR11001.1, C_TMR12001.1, C_TMR13001.1, C_TMR14001.1, C_TMR15001.1, C_TMR16001.1, C_TMR17001.1, C_TMR18001.1, C_TMR19001.1, C_TMR20001.1, C_TMR21001.1, C_TMR22001.1, C_TMR23001.1, C_TMR24001.1, C_TMR25001.1, C_TMR26001.1, C_TMR27001.1, C_TMR28001.1, C_TMR29001.1, C_TMR30001.1, C_TMR31001.1, C_TMR32001.1, C_TMR33001.1, C_TMR34001.1, C_TMR35001.1, C_TMR36001.1, C_TMR37001.1, C_TMR38001.1, TMR8001.4 (GND), TMR9001.4 (GND), TMR10001.4 (GND), TMR11001.4 (GND), TMR12001.4 (GND), TMR13001.4 (GND), TMR14001.4 (GND), TMR15001.4 (GND), TMR16001.4 (GND), TMR17001.4 (GND), TMR18001.4 (GND), TMR19001.4 (GND), TMR20001.4 (GND), TMR21001.4 (GND), TMR22001.4 (GND), TMR23001.4 (GND), TMR24001.4 (GND), TMR25001.4 (GND), TMR26001.4 (GND), TMR27001.4 (GND), TMR28001.4 (GND), TMR29001.4 (GND), TMR30001.4 (GND), TMR31001.4 (GND), TMR32001.4 (GND), TMR33001.4 (GND), TMR34001.4 (GND), TMR35001.4 (GND), TMR36001.4 (GND), TMR37001.4 (GND), TMR38001.4 (GND); also elsewhere on the board

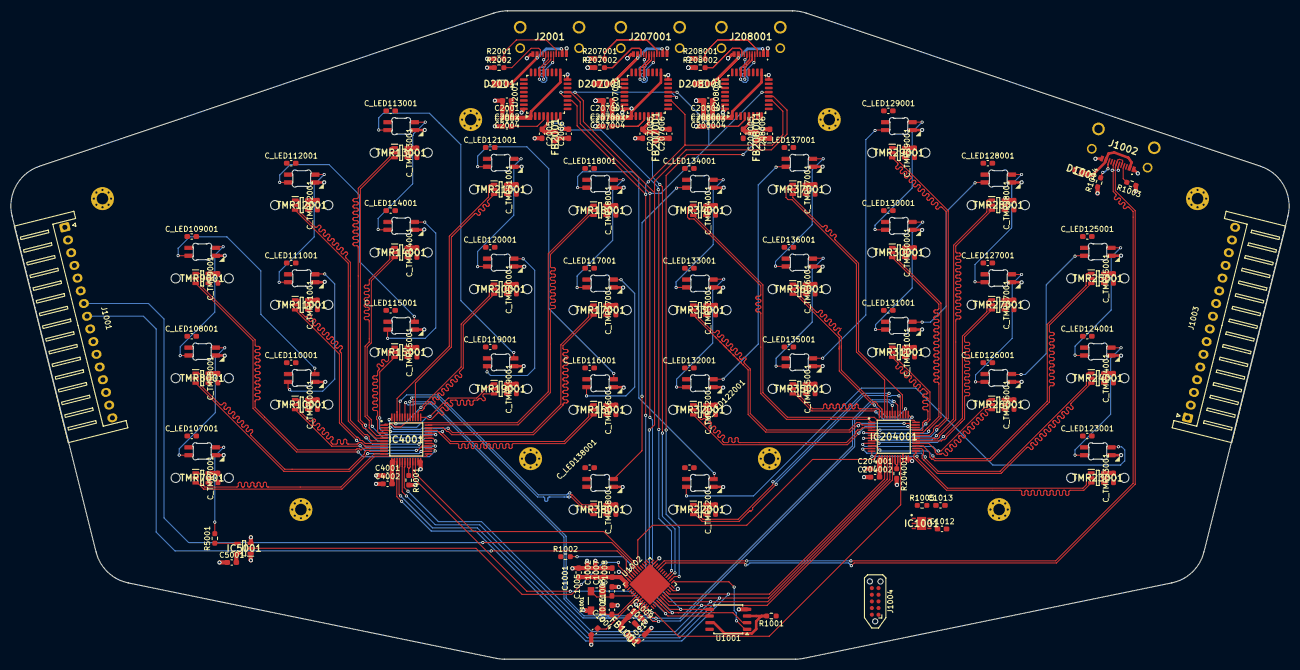
[picture p37: board RyzzenKeyboard.kicad_pcb from above]

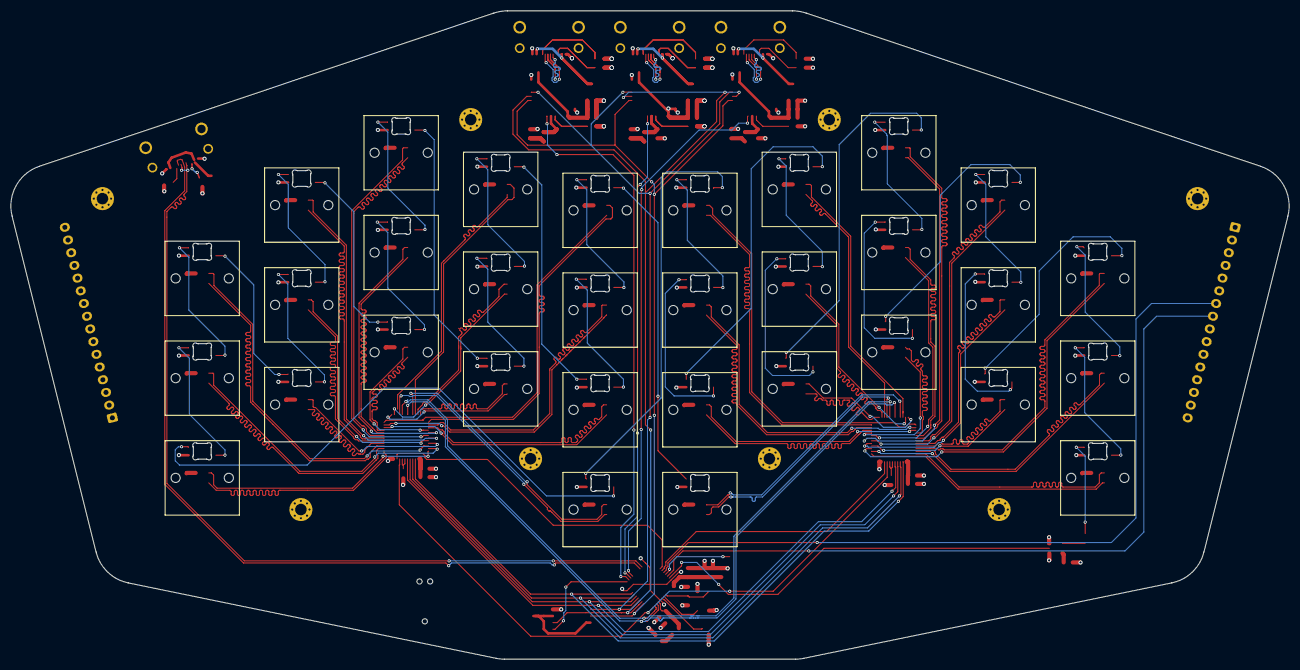
[picture p38: board RyzzenKeyboard.kicad_pcb from below]

Board: 4 copper layers, 244.1 x 123.8 mm, 243 parts (160 on the bottom side), 155 nets.

Other parts of the board:
SWITCH1, SWITCH2, SWITCH3, SWITCH4, SWITCH5, SWITCH6, SWITCH7, SWITCH8, SWITCH9, SWITCH10, SWITCH11, SWITCH12, SWITCH13, SWITCH14, SWITCH15, SWITCH16, SWITCH17, SWITCH18, SWITCH19, SWITCH20, SWITCH21, SWITCH22, SWITCH23, SWITCH24, SWITCH25, SWITCH26, SWITCH27, SWITCH28, SWITCH29, SWITCH30, SWITCH31, SWITCH32: SW_Cherry_MX_PCB_Mag_1.00u
_1, _2, _3, _4, _5, _6, _7, _8: MountingHole_2.2mm_M2_Pad_Via
