Ryzzen/RyzzenKeyboard/(commit log)

2025-12-15 [ADD](footprint) switches footprint
    [RyzzenKeyboard.kicad_pcb, RyzzenKeyboard.kicad_sch]
2025-12-16 [ADD](bank) added first 8 key bank
    [RyzzenKeyboard.kicad_sch, he_sensor.kicad_sch, key_bank.kicad_sch]
2025-12-17 [ADD](keys) added keys subsheet
    [RyzzenKeyboard.kicad_sch, he_sensor.kicad_sch, key_bank.kicad_sch, keys.kicad_sch]
2025-12-20 [ADD](mcu) added decoupling caps, boot reset and crystal
    [RyzzenKeyboard.kicad_sch]
2025-12-22 [ADD](crystal) added values for the crystal's capacitors
    [RyzzenKeyboard.kicad_sch]
2025-12-25 [UPDATE](TMR) switched to TMR sensors + added ldo
    [ECS-250-8-30B-CKM.step, RyzzenKeyboard.kicad_sch, he_sensor.kicad_sch, key_bank.kicad_sch, keys.kicad_sch]
2025-12-26 [ADD](HID SPI Bridge)
    [HID_SPI_bridge.kicad_sch, RyzzenKeyboard.kicad_sch, he_sensor.kicad_sch]
2025-12-28 [ADD](General) v1
    [HID_SPI_bridge.kicad_sch, RyzzenKeyboard.kicad_sch, he_sensor.kicad_sch, key_bank.kicad_sch, keys.kicad_sch]
2026-01-02 [ADD](General) v2 split
    [HID_SPI_bridge.kicad_sch, RyzzenKeyboard.kicad_sch, he_sensor.kicad_sch, key_bank.kicad_sch, keys.kicad_sch, led.kicad_sch, leds.kicad_sch]
2026-01-03 [FIX](General) footprints
    [HID_SPI_bridge.kicad_sch, RyzzenKeyboard.kicad_sch, he_sensor.kicad_sch, key_bank.kicad_sch, led.kicad_sch, leds.kicad_sch]
2026-01-04 [FIX](USB) main usb net labels
    [RyzzenKeyboard.kicad_sch, key_bank.kicad_sch, keys.kicad_sch, leds.kicad_sch]
2026-01-05 [ADD](General) added all footprints expect leds
    [HID_SPI_bridge.kicad_sch, RyzzenKeyboard.kicad_sch, he_sensor.kicad_sch, key_bank.kicad_sch, led.kicad_sch, leds.kicad_sch]
2026-01-06 [ADD](General) added all footprints
    [HID_SPI_bridge.kicad_sch, RyzzenKeyboard.kicad_pcb, RyzzenKeyboard.kicad_sch, led.kicad_sch]
2026-01-07 [ADD](PCB) outlines
    [RyzzenKeyboard.kicad_pcb]
2026-01-07 [ADD](ergogen) footprints
2026-01-07 [UPDATE](PCB) placed LEDs
    [HID_SPI_bridge.kicad_sch, RyzzenKeyboard.kicad_pcb, RyzzenKeyboard.kicad_sch, board.dxf, combo.dxf, he_sensor.kicad_sch, key_bank.kicad_sch, keys.dxf]
2026-01-08 [ADD](PCB) led and tmr caps placement
    [HID_SPI_bridge.kicad_sch, RyzzenKeyboard.kicad_pcb, RyzzenKeyboard.kicad_sch, he_sensor.kicad_sch, key_bank.kicad_sch, keys.kicad_sch, led.kicad_sch, leds.kicad_sch]
2026-01-09 [ADD](PCB) usbs and uc placement
    [RyzzenKeyboard.kicad_pcb, he_sensor.kicad_sch, key_bank.kicad_sch]
2026-03-23 [ADD](no clue)
    [RyzzenKeyboard.kicad_pcb, RyzzenKeyboard.kicad_sch, board.dxf, combo.dxf, key_bank.kicad_sch, keys.dxf, leds.kicad_sch, m2_countersink.dxf]
2026-04-11 [UPDATE](version 10)
    [RyzzenKeyboard.kicad_pcb]
