Ryzzen/RyzzenKeyboard/(notices)

Notices in the files:
librairies/switches_footprints/keyswitches.pretty-master/README.md:
CC BY-SA 4.0
